KilroyWasntHere/BoatCC/Hardware/MainPCB/PinList.ods

Pin | Used As | Function | HW Name
1 | In / Tach | Timer Capture | Ctimer0_Cap0
2 | In / Acc Interrupt | GPIO | PIO0_24
3 | Out / Acc SCL | SDIO Clock | FC4_SCL
4 | I/O / Acc SDA | SDIO Data | FC4_SDA
5 | USB DP | USB DP | USB_DP
6 | USB DP | USB DM | USB_DM
7 |  |  | PIO1_16/PDM0_CLK/SCT0_OUT5/Ctimer1_CAP3/FC7_CTS_SDA_SSEL0
8 |  |  | VDD
9 |  |  | VSS
10 | Out / Horn | Horn | PIO1_17
11 |  |  | PIO0_29/ADC_0/FC1_RXD_SDA_MOSI/SCT0_OUT2/Ctimer0_MAT3/Ctimer0_CAP1
12 | In / Extra | ADC | ADC0_1
13 | ISP Enable | GPIO | PIO1_0
14 | SPEED | ADC | ADC0_3
15 | ACCEL | ADC | ADC0_4
16 | TRANS | GPIO | PIO1_2
17 | USB_UP_LED | USB_UP_LED | USB_UP_LED
18 | TACH | ADC | ADC0_7
19 | Phase 1 Current Sense | ADC | ADC0_8
20 |  |  | VSSA
21 |  |  | VREFN
22 |  |  | VREFP
23 |  |  | VDDA
24 |  |  | VDD
25 |  |  | VSS
26 | USB_VBUS | USB_VBUS | USB_VBUS
27 | Phase 3 Current Sense | ADC | ADC0_10
28 | Phase 2 Current Sense | ADC | ADC0_11
29 | ARM LED | GPIO | PIO1_9
30 | Enable LED | GPIO | PIO1_10
31 | ISP_RX | UART | FC0_RXD
32 | ISP_TX | UART | FC0_TXD
33 |  |  | RTCXIN
34 |  |  | VDD
35 |  |  | RTCXOUT
36 |  |  | PIO0_2/FC0_CTS_SDA_SSEL0/FC3_SSEL3/CTIMER2_CAP1
37 |  |  | PIO0_3/FC0_RTS_SCL_SSEL1/FC2_SSEL2/Ctimer1_MAT3
38 | ISP Port | GPIO | PIO0_4
39 | RXD1 | UART | FC6_RXD
40 | TXD1 | UART | FC6_TXD
41 | Phase 1 | PWM | SCT0_OUT0
42 |  |  | PIO1_11/FC6_RTS_SCL_SSEL1/Ctimer1_CAP0/FC4_SCK
43 | Phase 2 | PWM | SCT0_OUT1
44 |  |  | PIO0_9/FC2_TXD_SCL_MISO/SCT0_OUT2/Ctimer3_CAP0/FC3_CTS_SDA_SSEL0
45 | Phase 3 | PWM | SCT0_OUT3
46 |  |  | PIO0_11/FC3_SCK/FC6_SDA_MOSI_DATA/Ctimer2_MAT1
47 |  |  | PIO0_12/FC3_RXD_SDA_MOSI/FC6_TXD_SCL_MISO_WS/Ctimer2_MAT3
48 | Clutch | PWM | SCT0_OUT4
49 |  |  | PIO0_14/FC3_CTS_SDA_SSEL0/SCT0_OUT5/Ctimer2_MAT1/FC1_SCK
50 | SWO | Debug | SW0
51 | Status LED 7 | GPIO | PIO1_12
52 | SWD Clock | Debug
53 | SWD I/O | Debug
54 | Status LED 6 | GPIO | PIO1_13
55 | VSS
56 | VDD
57 | GPS RX | UART | FC2_RXD
58 | Status LED 5 | GPIO | PIO0_18
59 | Status LED 4 | GPIO | PIO0_19
60 | Status LED 3 | GPIO | PIO0_20
61 | Status LED 2 | GPIO | PIO0_21
62 | Status LED 1 | GPIO | PIO1_15
63 | Status LED 0 | GPIO | PIO0_22
64 | Reset_N |  | RESET_N
