KilroyWasntHere/BoatCC/Hardware/MainPCB/Max16128Choice.ods

Digikey | Mouser | Limiter | Switch | UV Lockout | OV Lockout | CCK | Retries
Max16129UADFD |  | x |  | 7 | 29 | 9.7
Max16129UAAGA |  | x |  | 3 | 32 | None
Max16129UAEBD |  | x |  | 8 | 15 | 9.7
 | Max16128UAADAA |  | x | 3 | 21 | None | Infinite
 | Max16128UAACAC |  | x | 3 | 19 | None | Three
 | Max16129UAABA | x |  | 3 | 15 | None
 | Max16129UADFD | x |  | 7 | 29 | 9.7
 | Max16129UAAGA | x |  | 3 | 32 | None
 | Max16129UAEBD | x |  | 8 | 15 | 9.7
