KilroyWasntHere/BoatCC/Hardware/MainPCB/DirtyPCBs/Gerbers.png_Combined_Bottom.png

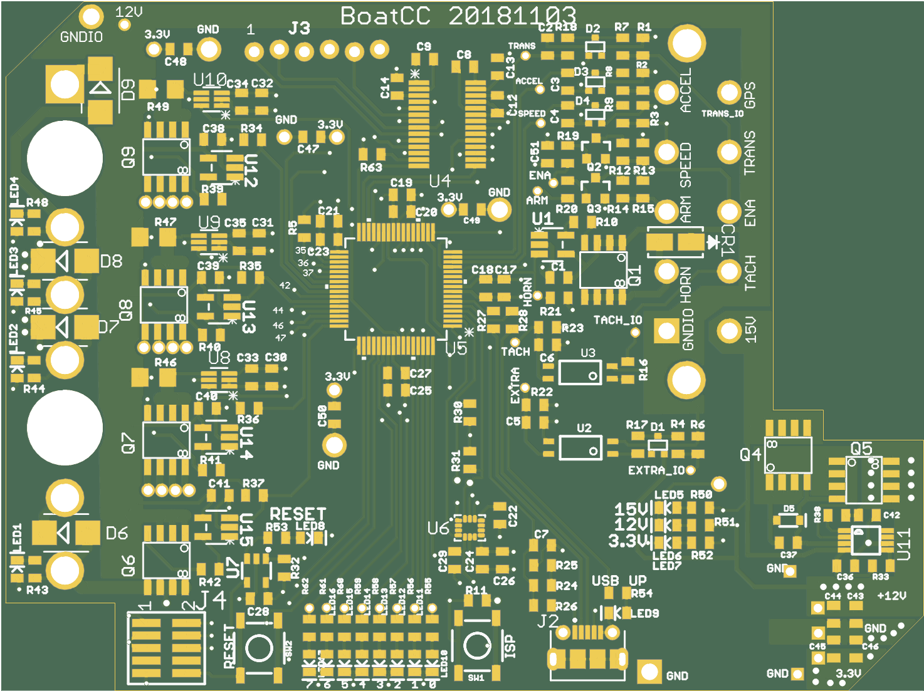
Hardware/MainPCB/DirtyPCBs/Gerbers.png_Combined_Bottom.png
