KilroyWasntHere/BoatCC/Hardware/MainPCB/DirtyPCBs/Gerbers.png_Combined_Top.png

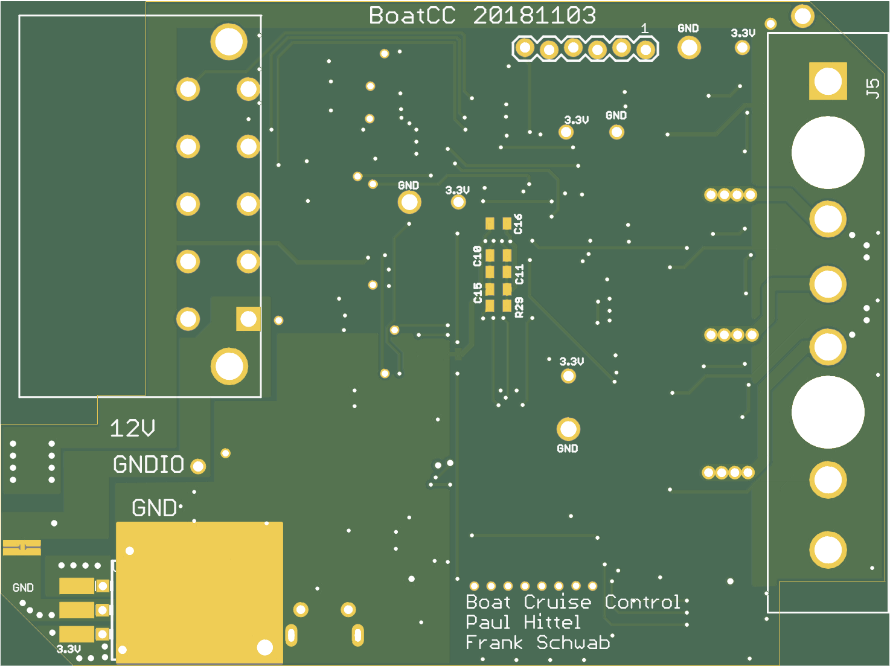
Hardware/MainPCB/DirtyPCBs/Gerbers.png_Combined_Top.png
