KilroyWasntHere/BoatCC/Hardware/MainPCB/SEED/Gerber.png_Combined_Bottom.png

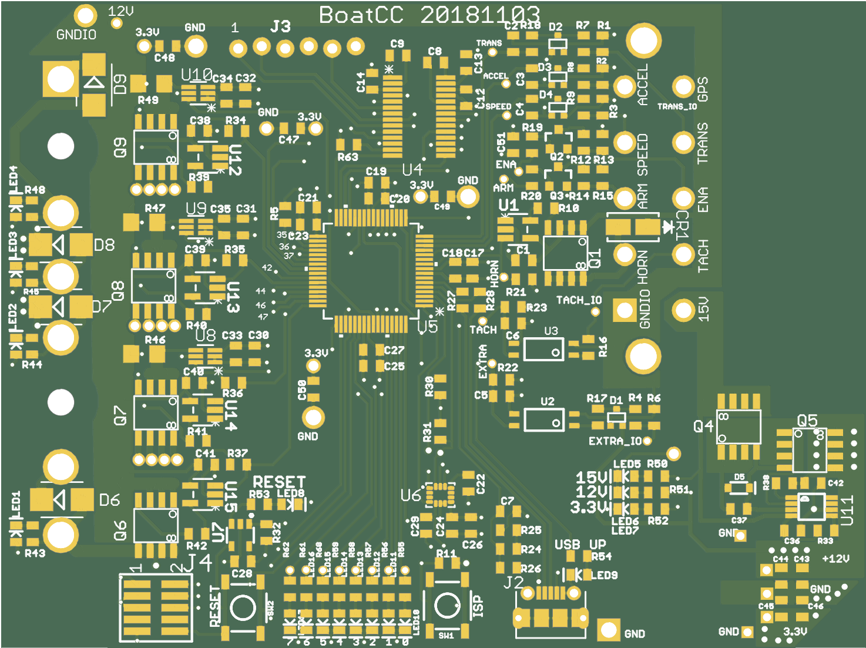
Hardware/MainPCB/SEED/Gerber.png_Combined_Bottom.png
