KilroyWasntHere/BoatCC/Hardware/MainPCB/boatcc_bom.ods

Qty | Current Stock | Price | Cost | Value | Device | Package | Parts | Description | ALT_DIGI-KEY_PART_NUMBER | ALT_DIGI-KEY_PURCHASE_URL | DIGI-KEY_PART_NUMBER | DIGI-KEY_PURCHASE_URL | MOUSER_PART_NUMBER | MOUSER_PURCHASE_URL | MANUFACTURER_PART_NUMBER | MF | MP | VALUE | VENDOR
10 |  | 0.08 | 0.8 | 10nf | 1CAP-0805 | 805 | C11, C18, C20, C23, C27, C29, C33, C34, C35, C37 | Ceramic capacitor |  |  |  |  |  |  |  |  |  | 0
30 | 30 | 0.08 | 2.4 | 100nf | 1CAP-0805 | 805 | C1, C2, C3, C4, C5, C6, C7, C8, C9, C12, C13, C14, C16, C17, C19, C21, C22, C24, C25, C28, C30, C31, C32, C36, C38, C39, C40, C41, C44, C45 | Ceramic capacitor |  |  |  |  |  |  |  |  |  | 0
5 |  | 0.08 | 0.4 | 1uf | 1CAP-0805 | 805 | C10, C26, C47, C49, C50 | Ceramic capacitor |  |  |  |  |  |  |  |  |  | 0
6 |  | 0.08 | 0.48 | 10uf | 1CAP-0805 | 805 | C15, C42, C43, C46, C48, C51 | Ceramic capacitor |  |  |  |  |  |  |  |  |  | 0
15 | 20 | 0.15 | 2.25 | Green | 1LED0805 | LED_0805 | LED1, LED2, LED3, LED4, LED5, LED6, LED7, LED9, LED11, LED12, LED13, LED14, LED15, LED16, LED17 | LED (Generic) |  |  | 732-4986-1-ND | https://www.digikey.com/product-detail/en/wurth-electronics-inc/150080VS75000/732-4986-1-ND/4489922 |  |  |  | WURTH Electronics | 150080VS75000
2 | 10 | 0.15 | 0.3 | Red | 1LED0805 | LED_0805 | LED8, LED10 | LED (Generic) |  |  | 732-4984-1-ND | https://www.digikey.com/product-detail/en/wurth-electronics-inc/150080RS75000/732-4984-1-ND/4489916 |  |  |  | WURTH Electronics | 150080RS75000
3 |  | 0.385 | 1.155 | R015 | 1RES-1206 | 1206 | R46, R47, R49 | Resistor |  |  | 408-1572-1-ND | https://www.digikey.com/product-detail/en/susumu/KRL1632E-M-R015-F-T5/408-1572-1-ND/3737754 |  |  |  |  |  | 10k
7 | 48 | 0.06 | 0.42 | 33 | 1RES-0805 | 805 | R10, R27, R28, R39, R40, R41, R42 | Resistor
2 | 36 | 0.06 | 0.12 | 49.9 | 1RES-0805 | 805 | R2, R3 | Resistor
2 | 45 | 0.06 | 0.12 | 100 | 1RES-0805 | 805 | R29, R38 | Resistor
11 |  | 0.06 | 0.66 | 350 | 1RES-0805 | 805 | R52, R53, R54, R55, R56, R57, R58, R59, R60, R61, R62 | Resistor
2 | 40 | 0.06 | 0.12 | 620 | 1RES-0805 | 805 | R12, R14 | Resistor
13 |  | 0.06 | 0.78 | 1k | 1RES-0805 | 805 | R1, R6, R7, R16, R17, R18, R19, R20, R22, R23, R44, R45, R48 | Resistor
3 |  | 0.06 | 0.18 | 3k | 1RES-0805 | 805 | R43, R50, R51
2 | 25 | 0.06 | 0.12 | 4k7 | 1RES-0805 | 805 | R8, R9 | Resistor
15 | 25 | 0.06 | 0.9 | 10k | 1RES-0805 | 805 | R5, R11, R21, R24, R25, R26, R30, R31, R32, R33, R34, R35, R36, R37, R63 | Resistor
3 |  |  | 0 | DNP | 1RES-0805 | 805 | R4, R13, R15 | Resistor
4 | 10 | 0.14 | 0.56 | BAV99WT1 | BAV99WT1 | SC70 | D1, D2, D3, D4 | Dual Series Switching Diode |  |  | BAV99WT1GOSCT-ND | https://www.digikey.com/product-detail/en/on-semiconductor/BAV99WT1G/BAV99WT1GOSCT-ND/917823 |  |  |  | ON Semiconductor | BAV99WT1G
1 |  | 0.14 | 0.14 | 18V | DIODE-ZENER-MM3Z3V3T1G | SOD-323 | D5 | Zener Diode |  |  | MM3Z18VT1GOSCT-ND | https://www.digikey.com/product-detail/en/on-semiconductor/MM3Z18VT1G/MM3Z18VT1GOSCT-ND/2121059 |  |  |  | ON Semiconductor | MM3Z18VT1G
4 | 10 | 0.33 | 1.32 | ES2D | ES2D | SMB | D6, D7, D8, D9 | DIODE |  |  | ES2DFSCT-ND | https://www.digikey.com/product-detail/en/on-semiconductor/ES2D/ES2DFSCT-ND/458941 |  |  |  | ON Semiconductor | ES2D
1 |  | 3.26 | 3.26 | ICM-20600 | ICM-20600 | PQFN50P250X300X97-14N | U6 | Low-Power, High-Performance Integrated 6-Axis MEMS MotionTracking Device in 2.5mm x 3mm Package |  |  | 1428-1147-1-ND | https://www.digikey.com/product-detail/en/tdk-invensense/ICM-20600/1428-1147-1-ND/9602942 |  |  |  | TDK InvenSense | ICM-20600
3 |  | 1.34 | 4.02 | INA213B | INA213AIDCKRDCK6-M | DCK6-M | U8, U9, U10 |  |  |  | 296-40129-1-ND | https://www.digikey.com/product-detail/en/texas-instruments/INA213BIDCKR/296-40129-1-ND/5178006 |  |  | INA213BIDCKR |  |  |  | Texas Instruments
1 | 3 | 2.65 | 2.65 | Recom R-78E3.3-0.5 | LM2931_FIXEDD2PAK/TO263 | D2PACK/A | U16 | LDO regulator with reverse battery protection- very durable! | 945-1661-5-ND | https://www.digikey.com/product-detail/en/recom-power/R-78E3.3-0.5/945-1661-5-ND/3593412 | 497-5225-1-ND | https://www.digikey.com/product-detail/en/stmicroelectronics/LF33ABDT-TR/497-5225-1-ND/1121678 |  |  |  | STMicroelectronics | LF33ABDT-TR
1 |  | 5.88 | 5.88 | LPC54114 | LPC5411XJXXXBD64LQFP64_10X10-M | LQFP64_10X10-M | U5 | Microprocessor |  |  | 568-13034-ND | https://www.digikey.com/product-detail/en/nxp-usa-inc/LPC54114J256BD64QL/568-13034-ND/5981474 |  |  |  | NXP | LPC54114J256BD64QL
1 | 6 | 3.08 | 3.08 | MAX16128 | MAX16128 | UMAX8 | U11 | Load Dump/Reverse Voltage Protection Circuit |  |  |  |  | 700-MAX16128UAACAC+T | https://www.mouser.com/ProductDetail/Maxim-Integrated/MAX16128UAACAC%2bT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 |  | MAXIM | MAX16129UADFD+
1 | 1 | 2.08 | 2.08 | MAX3243 | MAX3243_PW_28HEAVY | PW28-M | U4 | RS-232 Transceiver |  |  | 296-19809-1-ND | https://www.digikey.com/product-detail/en/texas-instruments/MAX3243EIDWR/296-19809-1-ND/1120550 |  |  |  | Texas Instruments | MAX3243EIDWR
1 | 1 | 0.61 | 0.61 | MCP1319M | MCP1319M | SOT23-5 | U7 | Supervisor/Controlled Reset IC |  |  | MCP1319MT-29LE/OTCT-ND | https://www.digikey.com/product-detail/en/microchip-technology/MCP1319MT-29LE-OT/MCP1319MT-29LE-OTCT-ND/1979885 |  |  |  | Microchip Technology | MCP1319MT-29LE/OT
5 | 5 | 0.67 | 3.35 | MCP1416 | MCP1416SOT-23-5_MCM | SOT-23-5_MC-M | U1, U12, U13, U14, U15 | FET Driver |  |  | MCP1416T-E/OTCT-ND | https://www.digikey.com/product-detail/en/microchip-technology/MCP1416T-E-OT/MCP1416T-E-OTCT-ND/1963940 |  |  |  | Microchip Technology | MCP1416T-E/OTCT-ND
2 |  | 0.33 | 0.66 | ISP | MOMENTARY-SWITCH-SPST-2-SMD-5.2MM | TACTILE_SWITCH_SMD_5.2MM | SW1, SW2 | Momentary Switch (Pushbutton) - SPST - Two Circuits |  |  | CKN9104CT-ND | https://www.digikey.com/product-detail/en/c-k/PTS525SM15SMTR2-LFS/CKN9104CT-ND/1146923 |  |  |  | C&K | PTS525SM15SMTR2 LFS
1 |  | 2.78 | 2.78 | FTSH-105-01 | SAMTEC-FTSH-105-01-X-DVJ | SAMTEC-FTSH-105-01-X-DV | J4 | 2x5 Connector for SWD |  |  | SAM13933CT-ND | https://www.digikey.com/product-detail/en/samtec-inc/FTSH-105-01-L-DV-007-P-TR/SAM13933CT-ND/9594226 |  |  |  | Samtec Inc. | FTSH-105-01-L-DV-007-P-TR
7 | 23 | 1.9 | 13.3 | SI4190DY | SI4190DY | SO-8 | Q1, Q4, Q5, Q6, Q7, Q8, Q9 | Vishay SI4190DY FET |  |  | SI4190ADY-T1-GE3 | https://www.digikey.com/product-detail/en/vishay-siliconix/SI4190ADY-T1-GE3/SI4190ADY-T1-GE3CT-ND/3178403 |  |  |  | Vishay Siliconix | SI4190ADY-T1-GE3
 |  | 0.57 |  | DMT6016LSS-13 | Replacement for SI4190DY | SO-8 |  |  |  |  | DMT6016LSS-13DICT-ND | https://www.digikey.com/product-detail/en/diodes-incorporated/DMT6016LSS-13/DMT6016LSS-13DICT-ND/4967052
1 |  | 0.49 | 0.49 | SMAJ45CASMASERIES-M | SMAJ45CASMASERIES-M | SMASERIES-M | CR1 |  |  |  | SMAJ24CALFCT-ND | https://www.digikey.com/product-detail/en/littelfuse-inc/SMAJ24CA/SMAJ24CALFCT-ND/762501 |  |  | SMAJ24CA |  |  |  | Littelfuse Inc
2 |  | 0.47 | 0.94 | TLP292 | TLP290 | MINI-FLAT-4 | U2, U3 | TOSHIBA PHOTOCOUPLER GaAs IRED & PHOTO-TRANSISTOR |  |  | TLP292(GB-TPLECT-ND | https://www.digikey.com/product-detail/en/toshiba-semiconductor-and-storage/TLP292-GB-TPLE/TLP292-GB-TPLECT-ND/4562959 |  |  |  | Toshiba Semiconductor | TLP292(GB-TPL,E
2 | 3000 | 0.14 | 0.28 | 2N3904 | TRANS_NPN-MMBT2222AL | SOT23-3 | Q2, Q3 | NPN transistor |  |  | MMBT2222AWT1GOSCT-ND | https://www.digikey.com/product-detail/en/on-semiconductor/MMBT2222AWT1G/MMBT2222AWT1GOSCT-ND/1139807 |  |  |  | ON Semiconductor | MMBT2222AWT1G
1 |  | 0.97 | 0.97 | CONN_USB_MICRO | USB_MICRO | MOLEX_1050170001 | J2 | USB Micro-B SMT connector |  |  | WM1399CT-ND | https://www.digikey.com/product-detail/en/molex-llc/1050170001/WM1399CT-ND/2350885 |  |  |  | Molex, LLC | 1050170001
160 |  |  | 56.775
