KilroyWasntHere/BoatCC/Hardware/MainPCB/LEDs.ods

LED | Color | Current | Vf | Input | Resistor | DK Part # | Description
LED1 | Green | 0.004 | 1.9 | 14.4 | 3125 | 475-1409-1-ND (http://www.digikey.com/product-detail/en/LG%20Q971-KN-1/475-1409-1-ND/1802597) | Clutch
LED2 | Green | 0.012 | 1.9 | 14.4 | 1024.59016393443 | 475-1409-1-ND (http://www.digikey.com/product-detail/en/LG%20Q971-KN-1/475-1409-1-ND/1802597) | Motor
LED3 | Green | 0.004 | 1.9 | 3.3 | 350 | 475-1409-1-ND (http://www.digikey.com/product-detail/en/LG%20Q971-KN-1/475-1409-1-ND/1802597) | SW16
LED4 | Green | 0.012 | 1.9 | 14.4 | 1024.59016393443 | 475-1409-1-ND (http://www.digikey.com/product-detail/en/LG%20Q971-KN-1/475-1409-1-ND/1802597) | Motor
LED5 | Green | 0.004 | 1.9 | 3.3 | 350 | 475-1409-1-ND (http://www.digikey.com/product-detail/en/LG%20Q971-KN-1/475-1409-1-ND/1802597) | SW17
LED6 | Green | 0.004 | 1.9 | 3.3 | 350 | 475-1409-1-ND (http://www.digikey.com/product-detail/en/LG%20Q971-KN-1/475-1409-1-ND/1802597) | SW18
LED7 | Green | 0.004 | 1.9 | 14.4 | 3125 | 475-1409-1-ND (http://www.digikey.com/product-detail/en/LG%20Q971-KN-1/475-1409-1-ND/1802597) | Motor
LED8 | Green | 0.004 | 1.9 | 3.3 | 350 | 475-1409-1-ND (http://www.digikey.com/product-detail/en/LG%20Q971-KN-1/475-1409-1-ND/1802597) | SW19
LED9 | Green | 0.004 | 1.9 | 3.3 | 350 | 475-1409-1-ND (http://www.digikey.com/product-detail/en/LG%20Q971-KN-1/475-1409-1-ND/1802597) | SW0_17
LED10 | Green | 0.004 | 1.9 | 3.3 | 350 | 475-1409-1-ND (http://www.digikey.com/product-detail/en/LG%20Q971-KN-1/475-1409-1-ND/1802597) | SW0_18
LED11 | Green | 0.004 | 1.9 | 3.3 | 350 | 475-1409-1-ND (http://www.digikey.com/product-detail/en/LG%20Q971-KN-1/475-1409-1-ND/1802597) | SW0_19
LED12 | Red | 0.004 | 1.8 | 3.3 | 375 | 475-2512-1-ND (http://www.digikey.com/product-detail/en/LS%20Q976-NR-1/475-2512-1-ND/1802639) | SW0_20
LED13 | Red | 0.004 | 1.8 | 3.3 | 375 | 475-2512-1-ND (http://www.digikey.com/product-detail/en/LS%20Q976-NR-1/475-2512-1-ND/1802639) | RESETLED
LED14 | Green | 0.004 | 1.9 | 3.3 | 350 | 475-1409-1-ND (http://www.digikey.com/product-detail/en/LG%20Q971-KN-1/475-1409-1-ND/1802597) | 3.3v
LED15 | Green | 0.004 | 1.9 | 14.4 | 3125 | 475-1409-1-ND (http://www.digikey.com/product-detail/en/LG%20Q971-KN-1/475-1409-1-ND/1802597) | 15v
LED16 | Green | 0.004 | 1.9 | 14.4 | 3125 | 475-1409-1-ND (http://www.digikey.com/product-detail/en/LG%20Q971-KN-1/475-1409-1-ND/1802597) | 12v
ARM | Red | 0.024 | 2.2 | 14.4 | 508.333333333333
Enable | Green | 0.020 | 2.2 | 14.4 | 610
Current | Voltage | Vf | Resistor
10 | 14.4 | 2.200 | 1220
15 | 14.4 | 2.200 | 813
20 | 14.4 | 2.200 | 610
25 | 14.4 | 2.200 | 488
30 | 14.4 | 2.200 | 407
35 | 14.4 | 2.200 | 349
40 | 14.4 | 2.200 | 305
50 | 14.4 | 2.200 | 244
