KilroyWasntHere/BoatCC/Hardware/MainPCB/boatcc.pdf

A

B | B

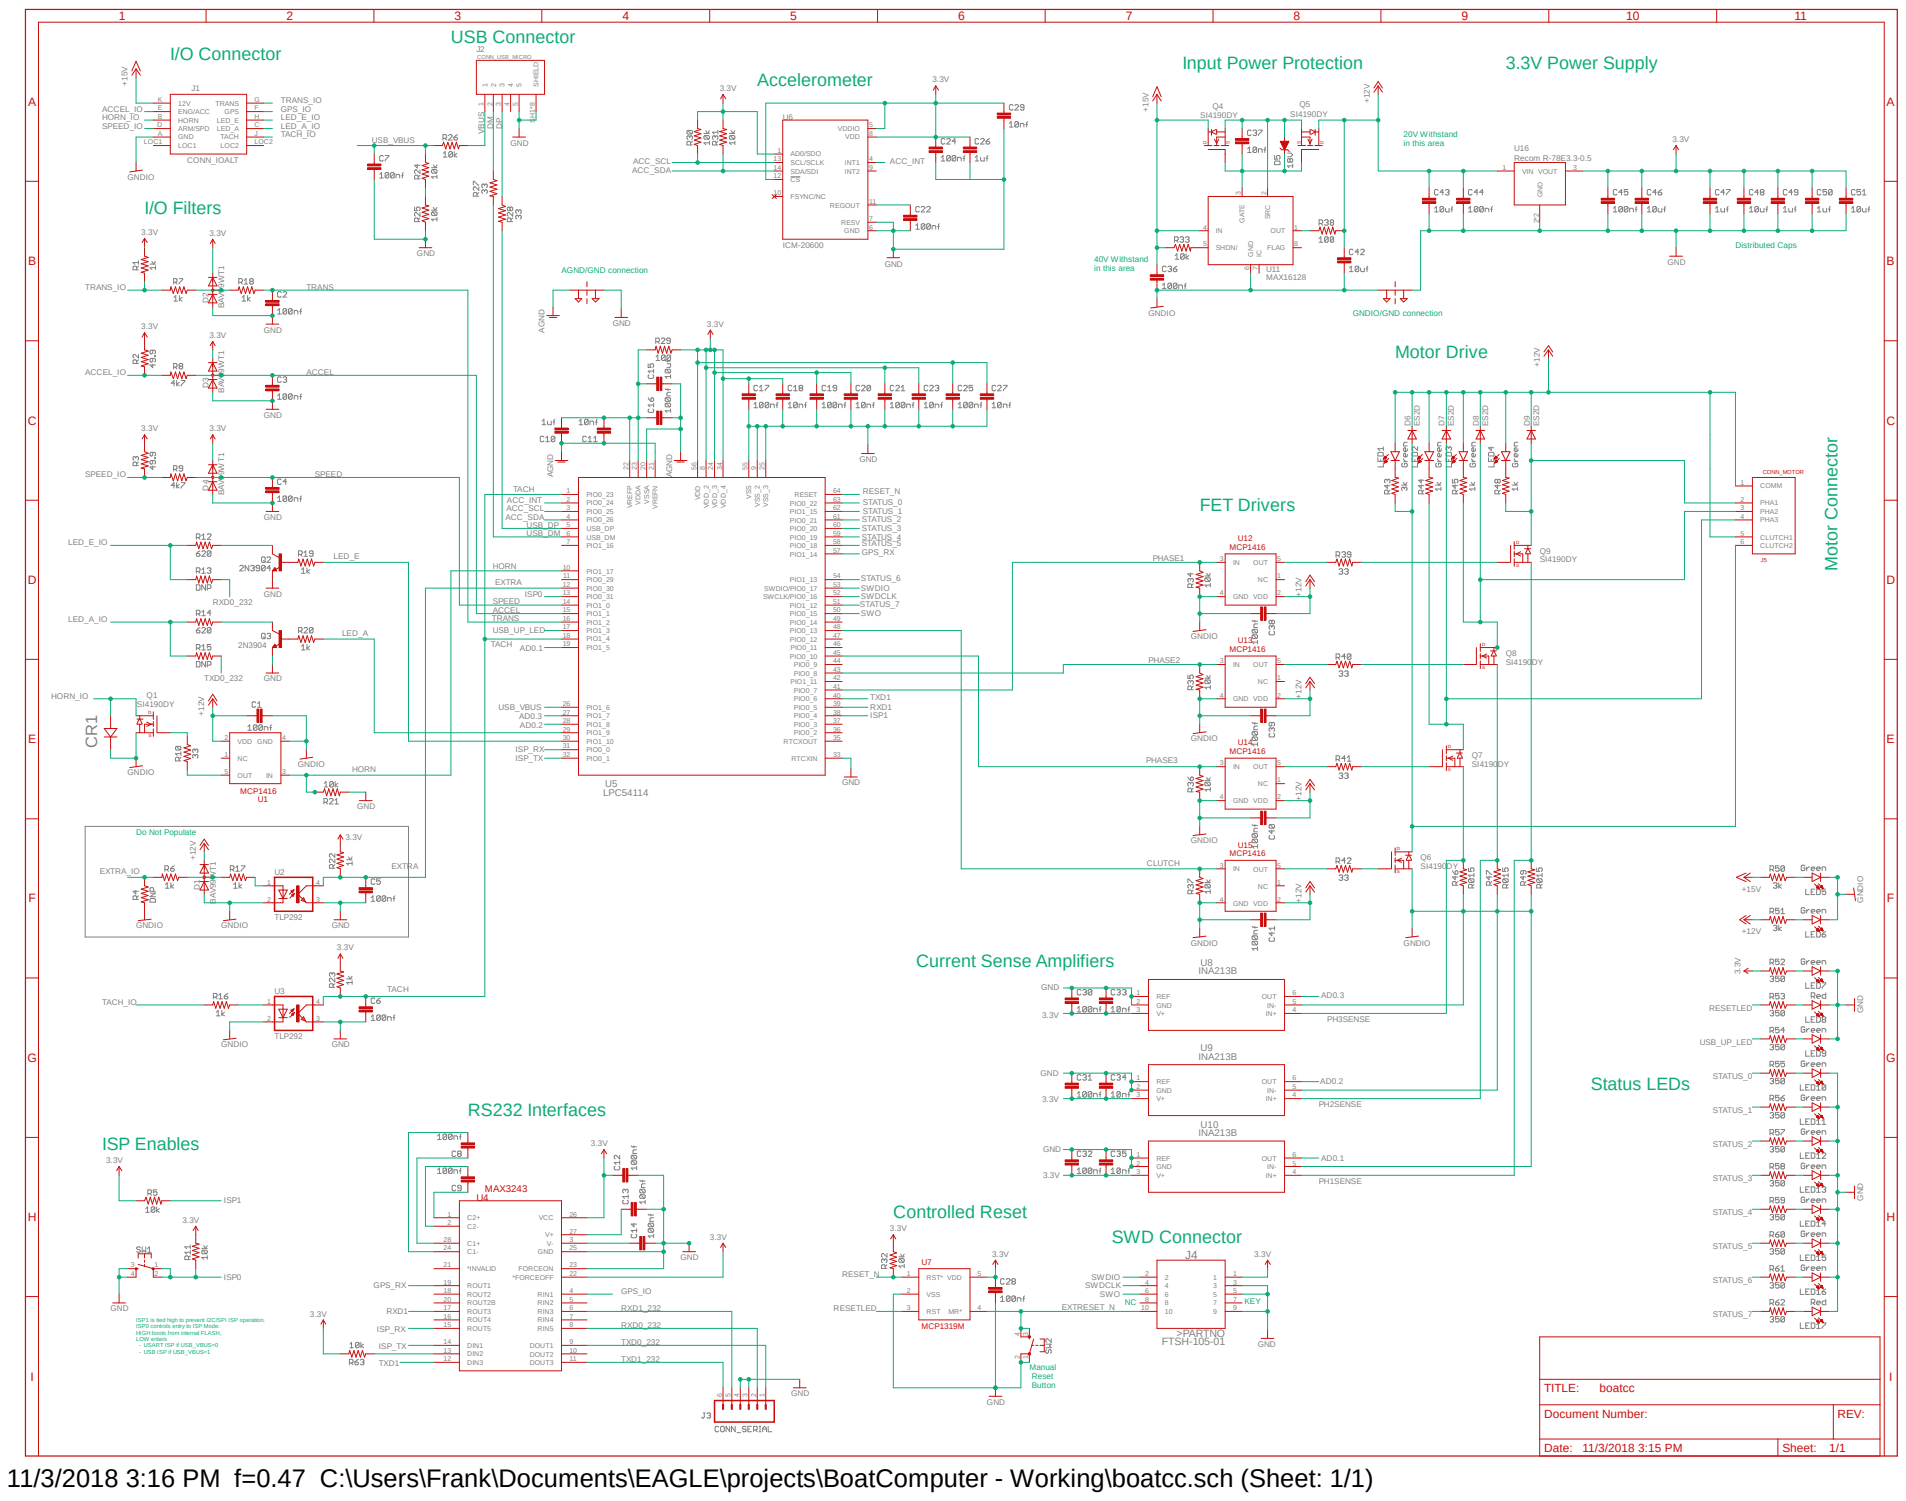
[picture p4: page 1]

ISP1 is tied high to prevent I2C/SPI ISP operation.
ISP0 controls entry to ISP Mode:
HIGH boots from internal FLASH,
LOW enters
- USART ISP if USB_VBUS=0
- USB ISP if USB_VBUS=1

11/3/2018 3:16 PM f=0.47 C:\Users\Frank\Documents\EAGLE\projects\BoatComputer - Working\boatcc.sch (Sheet: 1/1)
