KilroyWasntHere/BoatCC/Hardware/MainPCB/boatcc.brd

## EAGLE design Hardware/MainPCB/boatcc.brd (2018-11-04)

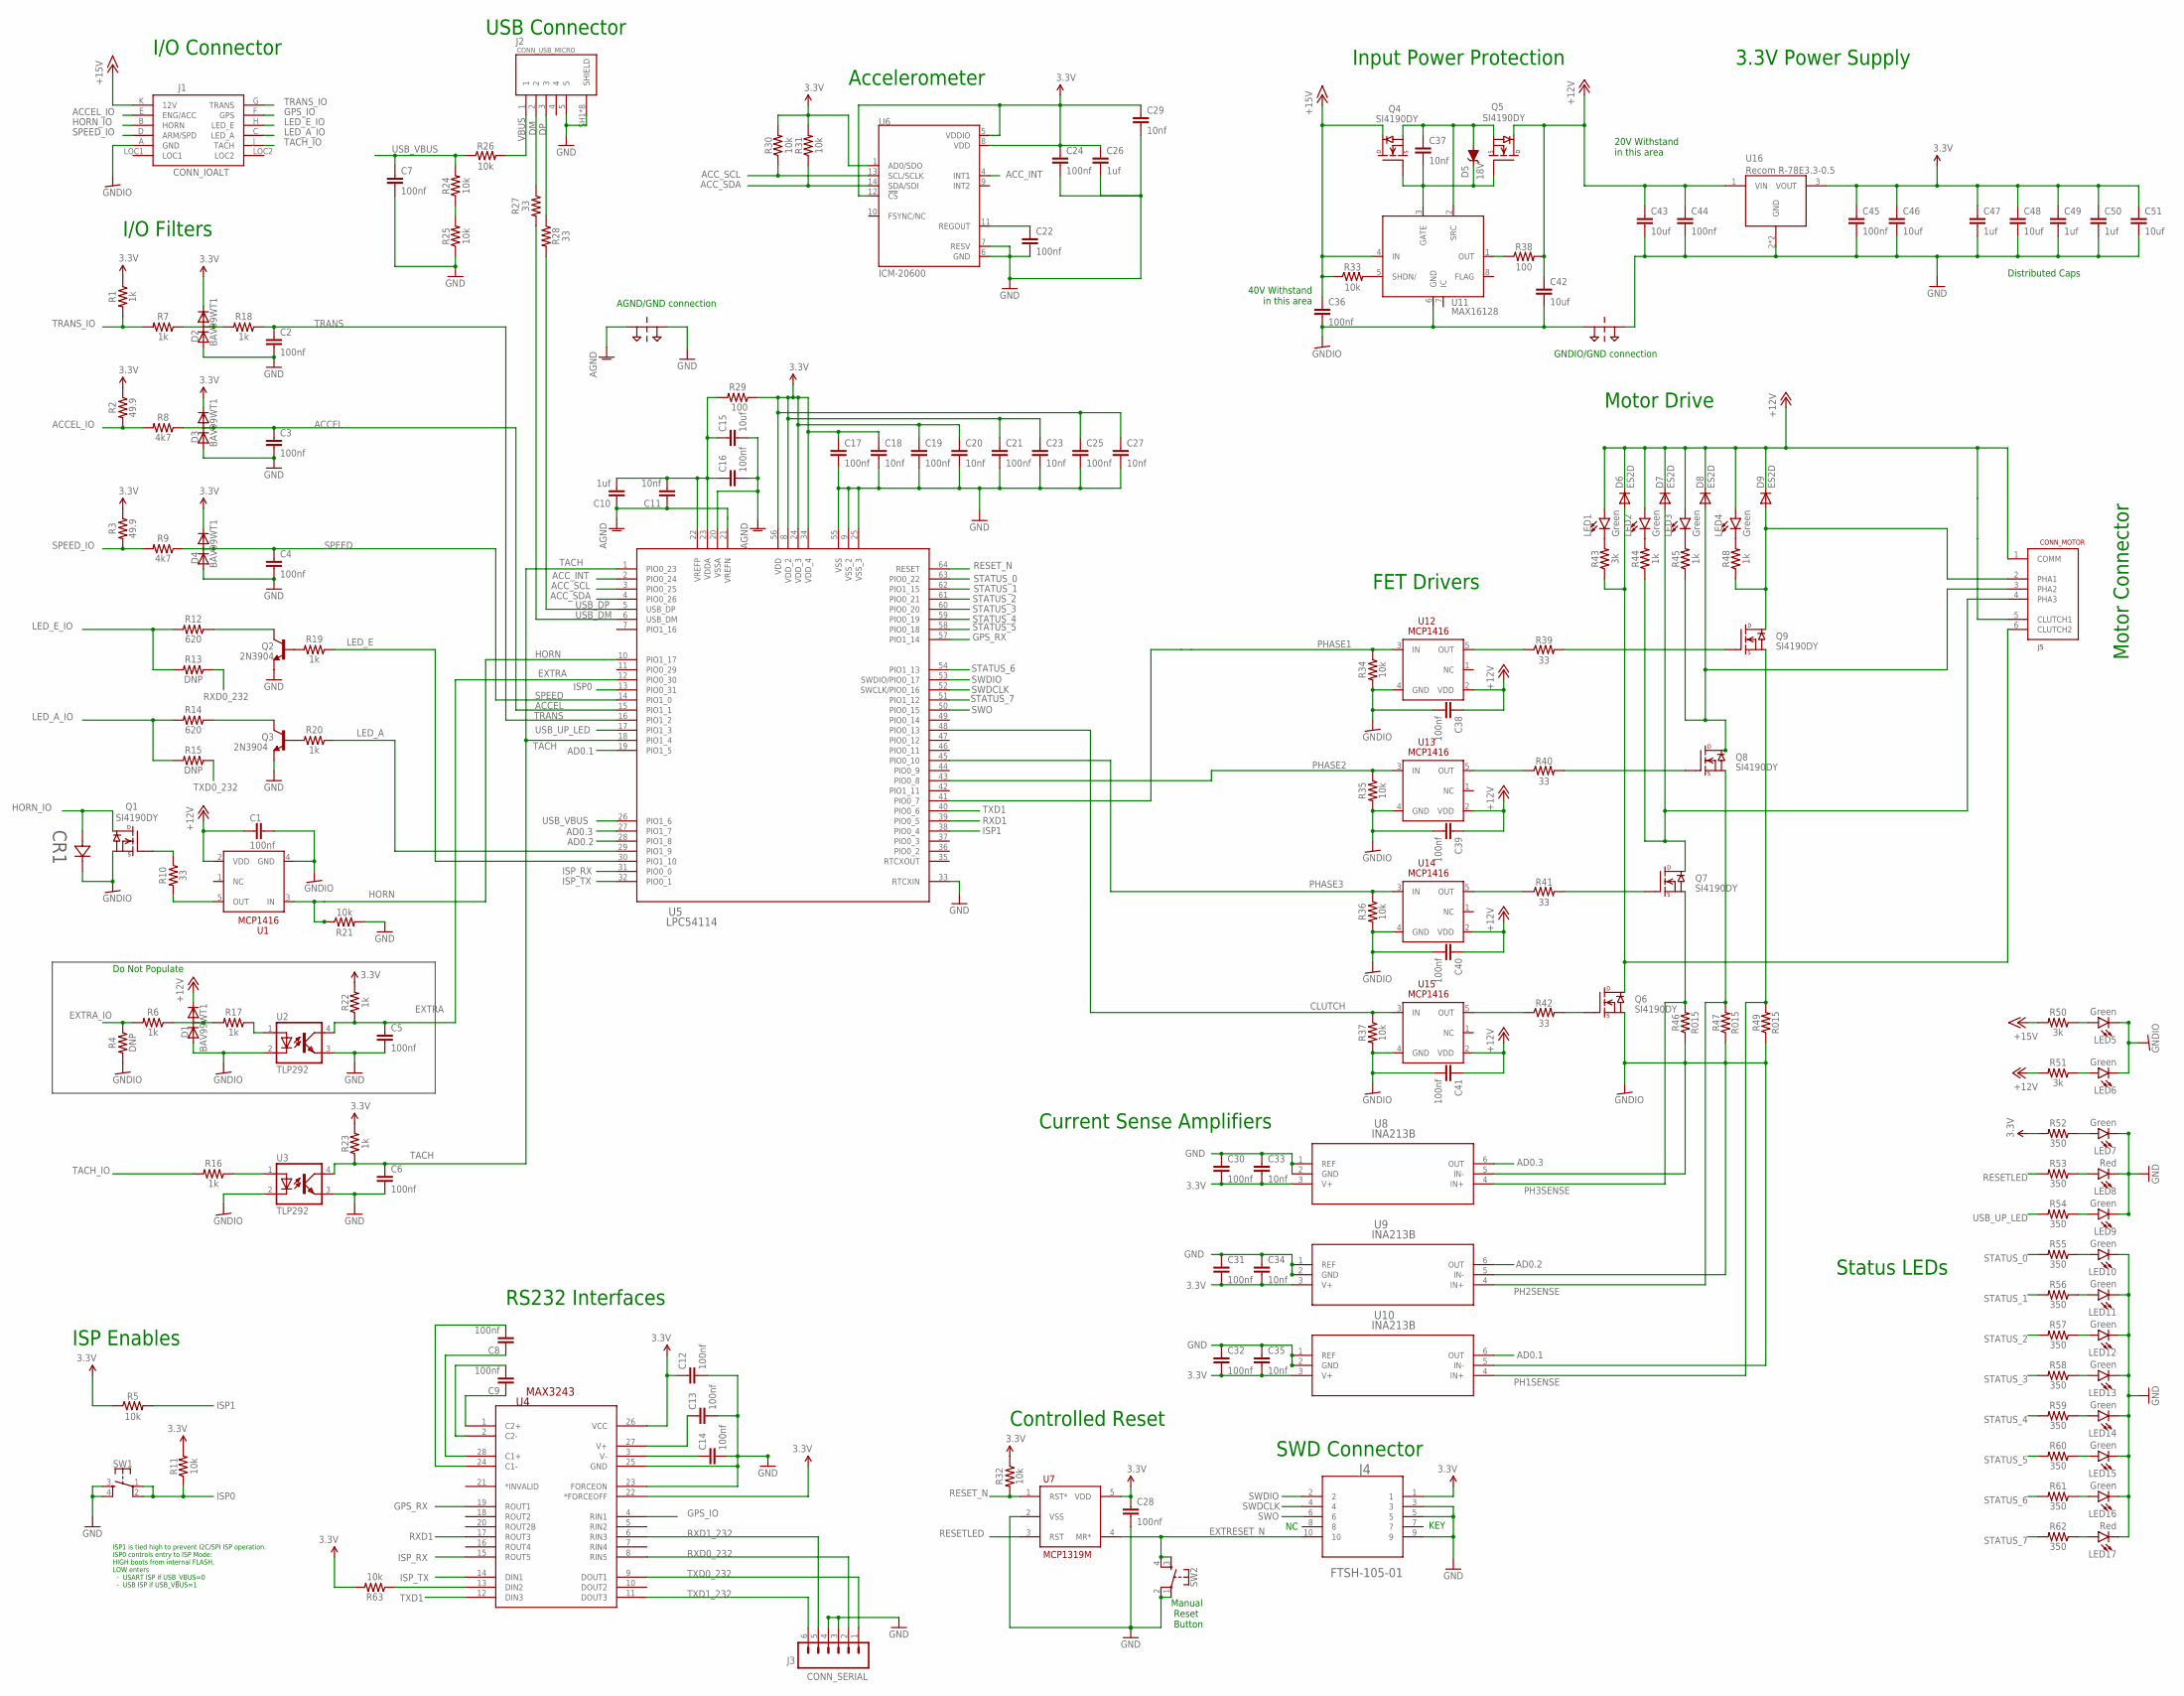
[picture p5: schematic boatcc.sch]

Parts:
C1, C2, C3, C4, C5, C6, C7, C8, C9, C12, C13, C14, C16, C17, C19, C21, C22, C24, C25, C28, C30, C31, C32, C36, C38, C39, C40, C41, C44, C45: 100nf; 0805
C10, C26, C47, C49, C50: 1uf; 0805
C11, C18, C20, C23, C27, C29, C33, C34, C35, C37: 10nf; 0805
C15, C42, C43, C46, C48, C51: 10uf; 0805
CR1: SMAJ45CASMASERIES-M; SMASERIES-M; MANUFACTURER_PART_NUMBER SMAJ24CA; DIGI-KEY_PART_NUMBER SMAJ24CALFCT-ND
D1, D2, D3, D4: BAV99WT1; SC70
D5: 18V; SOD-323
D6, D7, D8, D9: ES2D; SMB
J1: CONN_IOALT; CONN_IO
J2: CONN_USB_MICRO; MOLEX_1050170001
J3: CONN_SERIAL; 1X06_LOCK
J4: FTSH-105-01; SAMTEC-FTSH-105-01-X-DV
J5: CONN_MOTOR
LED1, LED2, LED3, LED4, LED5, LED6, LED7, LED9, LED10, LED11, LED12, LED13, LED14, LED15, LED16: Green; LED_0805; DIGI-KEY_PART_NUMBER 732-4986-1-ND
LED8, LED17: Red; LED_0805; DIGI-KEY_PART_NUMBER 732-4984-1-ND
Q1, Q4, Q5, Q6, Q7, Q8, Q9: SI4190DY; SO-8
Q2, Q3: 2N3904; SOT23-3
R1, R6, R7, R16, R17, R18, R19, R20, R22, R23, R44, R45, R48: 1k; 0805
R2, R3: 49.9; 0805
R4, R13, R15: DNP; 0805
R5, R11, R21, R24, R25, R26, R30, R31, R32, R33, R34, R35, R36, R37, R63: 10k; 0805
R8, R9: 4k7; 0805
R10, R27, R28, R39, R40, R41, R42: 33; 0805
R12, R14: 620; 0805
R29, R38: 100; 0805
R43, R50, R51: 3k; 0805
R46, R47, R49: R015; 1206; DIGI-KEY_PART_NUMBER 408-1572-1-ND
R52, R53, R54, R55, R56, R57, R58, R59, R60, R61, R62: 350; 0805
SUPPLY1, SUPPLY2: 2PT_GND_TIE
SW1, SW2: MOMENTARY-SWITCH-SPST-2-SMD-5.2MM; TACTILE_SWITCH_SMD_5.2MM
U1, U12, U13, U14, U15: MCP1416; SOT-23-5_MC-M
U2, U3: TLP292; MINI-FLAT-4; DIGI-KEY_PART_NUMBER TLP292(GB-TPLECT-ND
U4: MAX3243; PW28-M
U5: LPC54114; LQFP64_10X10-M
U6: ICM-20600; PQFN50P250X300X97-14N
U7: MCP1319M; SOT23-5
U8, U9, U10: INA213B; DCK6-M; MANUFACTURER_PART_NUMBER INA213BIDCKR; DIGI-KEY_PART_NUMBER 296-40129-1-ND
U11: MAX16128; UMAX8; MOUSER_PART_NUMBER 700-MAX16128UAACAC+T
U16: Recom R-78E3.3-0.5; D2PACK/A; DIGI-KEY_PART_NUMBER 497-5225-1-ND

Connections:
3.3V: C12.1, C17.1, C18.1, C19.1, C20.1, C21.1, C23.1, C24.1, C25.1, C26.1, C27.1, C28.1, C29.1, C30.2, C31.2, C32.2, C33.2, C34.2, C35.2, C45.1, C46.1, C47.1, C48.1, C49.1, C50.1, C51.1, D2.2 (C), D3.2 (C), D4.2 (C), J4.1, R1.1, R2.1, R3.1, R5.1, R11.2, R22.2, R23.2, R29.1, R30.2, R31.2, R32.1, R52.2, R63.2, U4.22 (*FORCEOFF), U4.26 (VCC), U5.8 (VDD_2), U5.24 (VDD_3), U5.34 (VDD_4), U5.56 (VDD), U6.1 (AD0/SDO), U6.5 (VDDIO), U6.8 (VDD), U6.12 (!CS), U7.5 (VDD), U8.3 (V+), U9.3 (V+), U10.3 (V+), U16.3 (VOUT)
+12V: C1.1, C38.1, C39.1, C40.1, C41.1, C42.1, C43.1, C44.1, D1.2 (C), D6.C, D7.C, D8.C, D9.C, J5.1 (COMM), J5.5 (CLUTCH1), LED1.A, LED2.A, LED3.A, LED4.A, Q5.5 (D), Q5.6 (D), Q5.7 (D), Q5.8 (D), R38.2, R51.2, U1.2 (VDD), U12.2 (VDD), U13.2 (VDD), U14.2 (VDD), U15.2 (VDD), U16.1 (VIN)
+15V: C36.1, J1.K (12V), Q4.5 (D), Q4.6 (D), Q4.7 (D), Q4.8 (D), R33.1, R50.2, U11.4 (IN)
ACCEL: C3.1, D3.3 (AC), R8.1, U5.15 (PIO1_1)
ACCEL_IO: J1.E (ENG/ACC), R2.2, R8.2
ACC_INT: U5.2 (PIO0_24), U6.4 (INT1)
ACC_SCL: R30.1, U5.3 (PIO0_25), U6.13 (SCL/SCLK)
ACC_SDA: R31.1, U5.4 (PIO0_26), U6.14 (SDA/SDI)
AD0.1: U5.19 (PIO1_5), U10.6 (OUT)
AD0.2: U5.28 (PIO1_8), U9.6 (OUT)
AD0.3: U5.27 (PIO1_7), U8.6 (OUT)
AGND: C10.1, C11.1, C15.2, C16.2, SUPPLY1.P$1, U5.20 (VSSA), U5.21 (VREFN)
CLUTCH: R37.1, U5.48 (PIO0_13), U15.3 (IN)
CLUTCH2: D6.A, J5.6 (CLUTCH2), Q6.5 (D), Q6.6 (D), Q6.7 (D), Q6.8 (D), R43.1
DM: J2.2, R27.1
DP: J2.3, R28.1
EXTRA: C5.1, R22.1, U2.4 (COL), U5.12 (PIO0_30)
EXTRA_IO: R4.1, R6.2
EXTRESET_N: J4.10, SW2.3, SW2.4, U7.4 (MR*)
FILTER_IN1: D1.3 (AC), R6.1, R17.2
GND: C2.2, C3.2, C4.2, C5.2, C6.2, C7.2, C12.2, C13.2, C14.2, C17.2, C18.2, C19.2, C20.2, C21.2, C22.2, C23.2, C24.2, C25.2, C26.2, C27.2, C28.2, C29.2, C30.1, C31.1, C32.1, C33.1, C34.1, C35.1, C43.2, C44.2, C45.2, C46.2, C47.2, C48.2, C49.2, C50.2, C51.2, D2.1 (A), D3.1 (A), D4.1 (A), J2.5, J2.SH1 (SHIELD), J2.SH2 (SHIELD), J2.SH3 (SHIELD), J2.SH4 (SHIELD), J2.SH5 (SHIELD), J2.SH6 (SHIELD), J2.SH7 (SHIELD), J2.SH8 (SHIELD), J3.3, J3.4, J4.3, J4.5, J4.9, LED7.C, LED8.C, LED9.C, LED10.C, LED11.C, LED12.C, LED13.C, LED14.C, LED15.C, LED16.C, LED17.C, Q2.2 (E), Q3.2 (E), R21.2, R25.1, SUPPLY1.P$2, SUPPLY2.P$2, SW1.3, SW1.4, SW2.1, SW2.2, U2.3 (EMIT), U3.3 (EMIT), U4.23 (FORCEON), U4.25 (GND), U5.9 (VSS_2), U5.25 (VSS_3), U5.33 (RTCXIN), U5.55 (VSS), U6.6 (GND), U6.7 (RESV), U7.2 (VSS), U8.1 (REF), U8.2 (GND), U9.1 (REF), U9.2 (GND), U10.1 (REF), U10.2 (GND), U16.2 (GND), U16.TAB (GND)
GNDIO: C1.2, C36.2, C38.2, C39.2, C40.2, C41.2, C42.2, CR1.1 (2), D1.1 (A), J1.A (GND), LED5.C, LED6.C, Q1.1 (S), Q1.2 (S), Q1.3 (S), Q6.1 (S), Q6.2 (S), Q6.3 (S), R4.2, R34.2, R35.2, R36.2, R37.2, R46.1, R47.1, R49.1, SUPPLY2.P$1, U1.4 (GND), U2.2 (C), U3.2 (C), U8.5 (IN-), U9.5 (IN-), U10.5 (IN-), U11.6 (GND), U12.4 (GND), U13.4 (GND), U14.4 (GND), U15.4 (GND)
GPS_IO: J1.F (GPS), U4.4 (RIN1)
GPS_RX: U4.19 (ROUT1), U5.57 (PIO1_14)
HORN: R21.1, U1.3 (IN), U5.10 (PIO1_17)
HORN_IO: CR1.2 (1), J1.B (HORN), Q1.5 (D), Q1.6 (D), Q1.7 (D), Q1.8 (D)
INT_PWR: C37.1, D5.A, Q4.1 (S), Q4.2 (S), Q4.3 (S), Q5.1 (S), Q5.2 (S), Q5.3 (S), U11.2 (SRC)
ISP0: R11.1, SW1.1, SW1.2, U5.13 (PIO0_31)
ISP1: R5.2, U5.38 (PIO0_4)
ISP_RX: U4.15 (ROUT5), U5.31 (PIO0_0)
ISP_TX: U4.14 (DIN1), U5.32 (PIO0_1)
LED_A: R20.1, U5.29 (PIO1_9)
LED_A_IO: J1.C (LED_A), R14.2, R15.2
LED_E: R19.1, U5.30 (PIO1_10)
LED_E_IO: J1.H (LED_E), R12.2, R13.2
MOTOR_PHASE_1: D9.A, J5.2 (PHA1), Q9.5 (D), Q9.6 (D), Q9.7 (D), Q9.8 (D), R48.1
MOTOR_PHASE_2: D8.A, J5.3 (PHA2), Q8.5 (D), Q8.6 (D), Q8.7 (D), Q8.8 (D), R45.1
MOTOR_PHASE_3: D7.A, J5.4 (PHA3), Q7.5 (D), Q7.6 (D), Q7.7 (D), Q7.8 (D), R44.1
unnamed: R41.1, U14.5 (OUT)
unnamed: Q2.1 (B), R19.2
unnamed: R10.2, U1.5 (OUT)
unnamed: LED1.C, R43.2
unnamed: Q3.1 (B), R20.2
unnamed: Q1.4 (G), R10.1
unnamed: Q7.4 (G), R41.2
unnamed: LED13.A, R58.1
unnamed: LED12.A, R57.1
unnamed: R17.1, U2.1 (A)
unnamed: R33.2, U11.5 (SHDN/)
unnamed: C37.2, D5.C, Q4.4 (G), Q5.4 (G), U11.3 (GATE)
unnamed: R39.1, U12.5 (OUT)
unnamed: Q9.4 (G), R39.2
unnamed: R40.1, U13.5 (OUT)
unnamed: LED5.A, R50.1
unnamed: LED11.A, R56.1
unnamed: Q8.4 (G), R40.2
unnamed: R38.1, U11.1 (OUT)
unnamed: LED10.A, R55.1
unnamed: LED8.A, R53.1
unnamed: LED7.A, R52.1
unnamed: R42.1, U15.5 (OUT)
unnamed: Q6.4 (G), R42.2
unnamed: LED16.A, R61.1
unnamed: LED2.C, R44.2
unnamed: LED3.C, R45.2
unnamed: LED4.C, R48.2
unnamed: C8.2, U4.24 (C1-)
unnamed: LED6.A, R51.1
unnamed: C8.1, U4.28 (C1+)
unnamed: D2.3 (AC), R7.1, R18.2
unnamed: C9.2, U4.2 (C2-)
unnamed: C9.1, U4.1 (C2+)
unnamed: C22.1, U6.11 (REGOUT)
unnamed: C13.1, U4.27 (V+)
unnamed: LED17.A, R62.1
unnamed: LED9.A, R54.1
unnamed: Q3.3 (C), R14.1
unnamed: Q2.3 (C), R12.1
unnamed: C14.1, U4.3 (V-)
unnamed: R24.1, R25.2
unnamed: R16.1, U3.1 (A)
unnamed: R63.1, U4.13 (DIN2)
unnamed: LED15.A, R60.1
unnamed: LED14.A, R59.1
PH1SENSE: Q9.1 (S), Q9.2 (S), Q9.3 (S), R49.2, U10.4 (IN+)
PH2SENSE: Q8.1 (S), Q8.2 (S), Q8.3 (S), R47.2, U9.4 (IN+)
PH3SENSE: Q7.1 (S), Q7.2 (S), Q7.3 (S), R46.2, U8.4 (IN+)
PHASE1: R34.1, U5.41 (PIO0_7), U12.3 (IN)
PHASE2: R35.1, U5.43 (PIO0_8), U13.3 (IN)
PHASE3: R36.1, U5.45 (PIO0_10), U14.3 (IN)
RESETLED: R53.2, U7.3 (RST)
RESET_N: R32.2, U5.64 (RESET), U7.1 (RST*)
RXD0_232: J3.2, R13.1, U4.8 (RIN5)
RXD1: U4.17 (ROUT3), U5.39 (PIO0_5)
RXD1_232: J3.5, U4.6 (RIN3)
SPEED: C4.1, D4.3 (AC), R9.1, U5.14 (PIO1_0)
SPEED_IO: J1.D (ARM/SPD), R3.2, R9.2
STATUS_0: R55.2, U5.63 (PIO0_22)
STATUS_1: R56.2, U5.62 (PIO1_15)
STATUS_2: R57.2, U5.61 (PIO0_21)
STATUS_3: R58.2, U5.60 (PIO0_20)
STATUS_4: R59.2, U5.59 (PIO0_19)
STATUS_5: R60.2, U5.58 (PIO0_18)
STATUS_6: R61.2, U5.54 (PIO1_13)
STATUS_7: R62.2, U5.51 (PIO1_12)
SWDCLK: J4.4, U5.52 (SWCLK/PIO0_16)
SWDIO: J4.2, U5.53 (SWDIO/PIO0_17)
SWO: J4.6, U5.50 (PIO0_15)
TACH: C6.1, R23.1, U3.4 (COL), U5.1 (PIO0_23), U5.18 (PIO1_4)
TACH_IO: J1.J (TACH), R16.2
TRANS: C2.1, R18.1, U5.16 (PIO1_2)
TRANS_IO: J1.G (TRANS), R1.2, R7.2
TXD0_232: J3.1, R15.1, U4.9 (DOUT1)
TXD1: U4.12 (DIN3), U5.40 (PIO0_6)
TXD1_232: J3.6, U4.11 (DOUT3)
USB_DM: R27.2, U5.6 (USB_DM)
USB_DP: R28.2, U5.5 (USB_DP)
USB_UP_LED: R54.2, U5.17 (PIO1_3)
USB_VBUS: C7.1, R24.2, R26.1, U5.26 (PIO1_6)
VBUS: J2.1, R26.2
VDDA: C10.2, C11.2, C15.1, C16.1, R29.2, U5.22 (VREFP), U5.23 (VDDA)

Notes on the sheet:
Manual Reset Button
3.3V Power Supply
Motor Drive
FET Drivers
Status LEDs
Controlled Reset
I/O Connector
Accelerometer
Input Power Protection
Motor Connector
I/O Filters
RS232 Interfaces
20V Withstand in this area
SWD Connector
ISP Enables
ISP1 is tied high to prevent I2C/SPI ISP operation. ISP0 controls entry to ISP Mode: HIGH boots from internal FLASH, LOW enters - USART ISP if USB_VBUS=0 - USB ISP if USB_VBUS=1
Distributed Caps
USB Connector
KEY
GNDIO/GND connection
AGND/GND connection
Current Sense Amplifiers
40V Withstand in this area
Do Not Populate

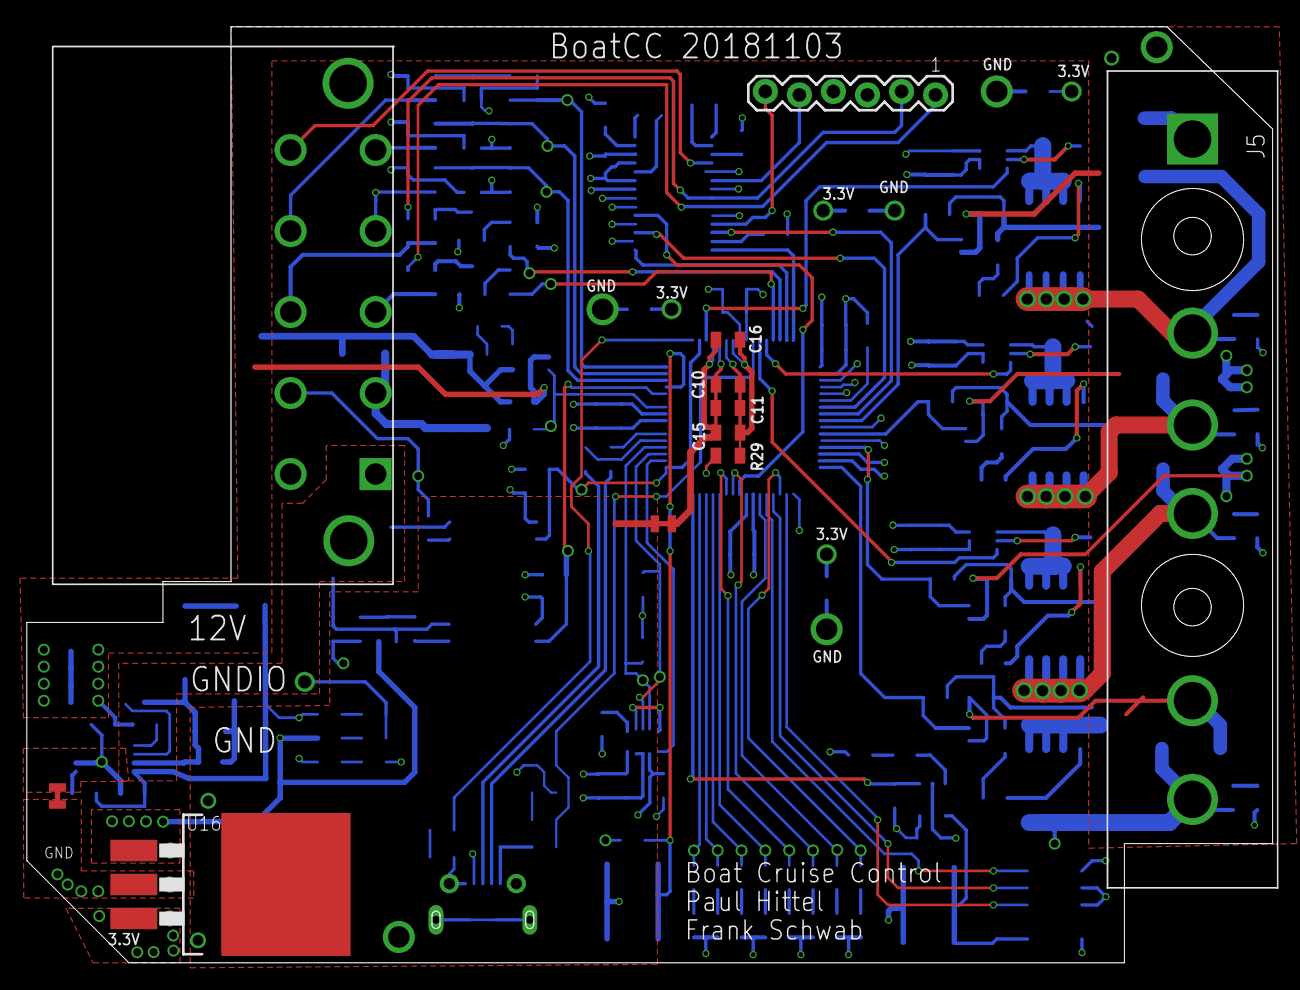
[picture p6: board boatcc.brd from above]

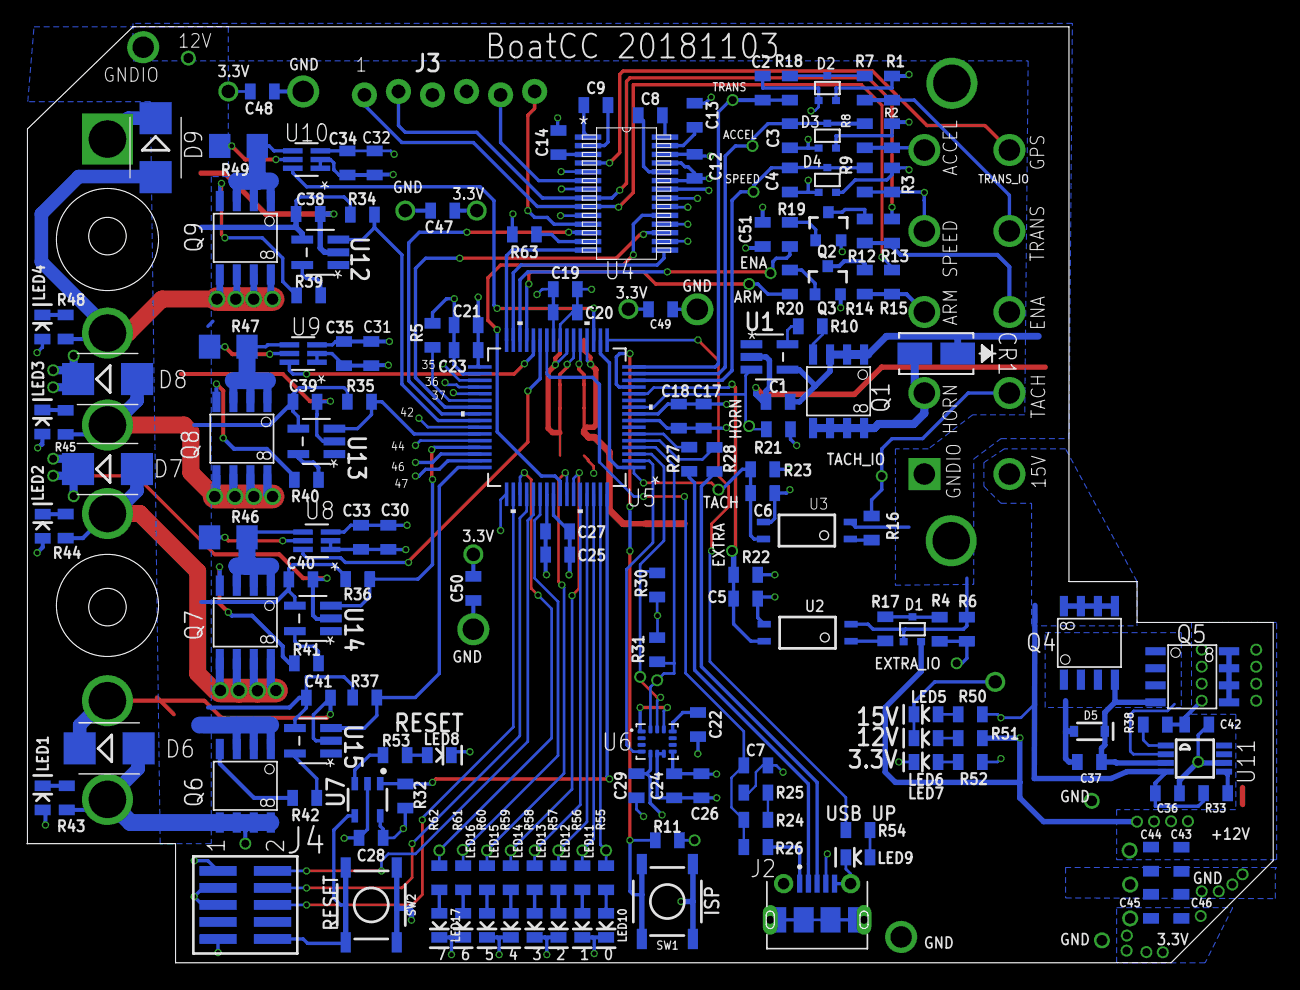
[picture p7: board boatcc.brd from below]

Board: 4 copper layers, 93.0 x 69.8 mm, 175 parts (164 on the bottom side), 121 nets.
